devilreraser/hw_crypto_miner_golden_nonce/(list of files, drawings)

Other design files:
Golden_Nonce/Schematic/BitCoin.PcbLib
Golden_Nonce/Schematic/Block.SchDoc
Golden_Nonce/Schematic/Golden_Nonce_Rev01.PrjPCB
Golden_Nonce/Schematic/GS_01_Core.SchDoc
Golden_Nonce/Schematic/GS_01_Pow.SchDoc
Golden_Nonce/Schematic/GS_02_Core.SchDoc
Golden_Nonce/Schematic/GS_02_Pow.SchDoc
Golden_Nonce/Schematic/MCU.SchDoc
Golden_Nonce/Schematic/Schlib1.SchLib
Golden_Nonce/Schematic/SMPS.SchDoc
